franavin/tdse-tf_2026-1erC_3-1/README.md

# FIUBA - Electrónica - Taller de Sistemas Embebidos
## Trabajo Final - 2026-1c - 3-1: Estación Hidropónica

### Bitácora de Entregas
| N° | Detalles | Fecha | Deadline |
| :--: | :--- | :---: | :---: |
| 01 | README.md | 08/05/26 | Semana 08 |
| 02 | Propuesta.md |23/05/26 | Semana 11 |
| 03 | Informe_de_Avance.md |12/06/26 | Semana 14 |
| 04 | Memoria_Video_Código.md |10/07/26 | Semana 17 |
