franavin/tdse-tf_2026-1erC_3-1/Memoria Técnica/Memoria_Video_Código.md

<div align="center">

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

**UNIVERSIDAD DE BUENOS AIRES**  
**Facultad de Ingeniería**  
**TA134 – Sistemas Embebidos**  
Curso 3 – Grupo 1

# Estación Hidropónica

## Autores
Avincetto, Franco Joaquín — Legajo 106747  
Nishihara, Leonardo — Legajo 88627 

**Fecha:** 20/08/2026  
**Cuatrimestre de cursada:** 1er cuatrimestre 2026  

*Trabajo realizado entre julio de 2026 y agosto de 2026*
</div>

---

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

---

## Registro de versiones

*Historial de revisiones del documento.*

La Tabla 0.1 resume el historial de revisiones y entregas de esta memoria.

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

<em>Tabla 0.1 — Registro de versiones del documento.</em><br><br>

---

# Índice General

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

---

# Capítulo 1: Introducción general

## 1.1 Análisis de necesidad y objetivo
El cultivo hidropónico es una técnica en la cual se prescinde por completo de un suelo en el que poner aquello que se quiere cultivar, utilizando en su lugar minerales disueltos en agua para formar el sustrato. Para que este método sea exitoso se requiere de ciertos cuidados estrictos en el entorno en que se desarrolla, tanto por los ciclos de oxigenación y el riego de las raíces como por la temperatura y humedad del ambiente. 

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

<div align="center">
  Rainbird
<br>
<em>Figura 1.2 — Programador Riego Por Goteo Grifo Automatico Rain Bird.</em>
  </div>
<br>

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

## 1.3 Justificación del enfoque técnico

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

Las limitaciones actuales radican, en primer lugar, en la validación de la etapa de potencia y el entorno, ya que para comprobar que la etapa de potencia funcionaría utilizamos la observación a partir de la conmutación de los relés a nivel lógico, y no unas bombas de agua conectadas a 220V con válvulas de agua conectada, esto es lo que quedaría para un estudio posterior. 

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

---

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

## 2.1 Requisitos
| Grupo | ID | Descripción |
| :---- | :---- | :---- |
| **Sensores** | 1.1 | **Nivel de agua (Simulado):** Lectura analógica por ADC (polling/DMA) de un potenciómetro, previo paso por un filtro activo Sallen-Key por hardware. |
| | 1.2 | **Clima (Real):** Lectura de temperatura y humedad ambiente utilizando el sensor digital SHT3x a través del bus I2C. |
| | 1.3 | **Interfaz de entrada local:** Lectura no bloqueante (con rutinas de anti-rebote por software) de botones para la navegación del menú y Dip Switches para alternar los modos del sistema (`NORMAL` / `SET_UP`). |
| **Actuadores** | 2.1 | **Actuadores de simulación (Bombas/Ventilación):** Encendido y apagado de LEDs/Relés gestionados por retardos no bloqueantes basados en el tick del Systick (1ms). |
| | 2.2 | **Alarmas sonoras:** Emisión de alertas mediante un Buzzer (accionado por PWM o GPIO) ante fallas críticas del sistema o confirmaciones de guardado. |
| **Interfaz y Comunicaciones** | 3.1 | **Interfaz Visual Local (Display):** Actualización periódica de un menú interactivo en una pantalla OLED (SPI/I2C) para la visualización y configuración de parámetros sin depender de la red. |
| | 3.2 | **Telemetría remota:** Envío de tramas de estado y alertas por UART utilizando un módulo Bluetooth HM-10 para monitoreo desde una aplicación móvil. |
| **Almacenamiento** | 4.1 | **Gestión de Recetas (EEPROM):** Lectura y escritura de parámetros de configuración (tiempos de riego, umbrales térmicos) en una memoria EEPROM externa vía I2C para garantizar la persistencia ante cortes de energía. |

<p align="center"><em>Tabla 2.1: Requisitos del proyecto</em></p>

---
## **2.2\. Casos de Uso**

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

## 2.3 Descripción de módulos principales

En los siguientes puntos desarrollaremos los modulos principales aplicados al proyecto. 

### 2.3.1 Módulo de control y orquestación de la plaqueta NUCLEO
* Implementado sobre una placa de desarrollo STM32 NUCLEO F103RB.
* Ejecuta un scheduler (Ejecutor Cíclico) basado en arreglos de punteros a funciones, disparando cada 1 ms por el SysTick.
* Centraliza la Máquina de Estados Finita (FSM) gobernando el comportamiento macro de la estación.
<div align="center">
image PF259875 en feature-description-include-personalized-no-cpn-large
<br>
<em>Figura 2.1: Placa NUCLEO-F103RB.</em>
  </div>
<br>

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

### 2.3.3 Módulo de medición ambiental
* Compuesto por el sensor digital AHT20 operando bajo el bus I2C.
* Utiliza un driver propio basado en estados internos que permite enviar el comando de medición y ceder el uso del procesador durante los 80 ms físicos requeridos para el cálculo termodinámico, evitando el uso de funciones bloqueantes.

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

### 2.3.5 Módulo de memoria
* Utiliza la memoria externa EEPROM AT24C32 en el bus I2C compartiendo líneas con el sensor AHT20.
* Minimiza la tasa de desgaste de escritura al funcionar como sistema de solo respaldo: se lee una sola vez durante el inicio del sistema (Init) y se escribe de manera exclusiva cuando los valores han sido explícitamente confirmados por el usuario.

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

### 2.3.6 Módulo de telemetría
* Integrado mediante el modulo bluetooth HM-10.
* Opera de forma totalmente asincrónica a través del periférico USART de la STM32, donde veremos que su impacto en el rendimiento computacional de la placa es nulo en estado de reposo, procesando tramas únicamente mediante interrupciones.

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

---

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

Primero realizamos la estructuración a partir de los componentes que podría llegar a tener el sistema, haciendo un Diagrama en Bloques. Seguido a eso, completamos un primer Diagrama de Secuencia que reflejaba prácticamente lo mismo que el de bloques, y pasamos a definir los eventos y estados que deberían tener en un principio.
En los enlaces siguientes se presentan en detalle las tablas de estados definidas para cada módulo.

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

Una vez logrado eso, completamos un último Diagrama de Secuencia donde en los mensajes contenía la impronta de lo que iba a volcarse en el código.

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

<p align="center"><em>Figura 3.1: Diagrama de bloques</em></p>

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

<p align="center"><em>Figura 3.2: Diagrama de Secuencia</em></p>

## 3.2 Diseño de hardware
El hardware constará de una placa base para los siguientes periféricos:

<div align="center">
Esquematico
<br>
<em>Figura 3.3: Esquemático del sistema.</em>
  </div>
<br>

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

## 3.3 Diseño de firmware
El sistema no utiliza un RTOS, sino una arquitectura bare-metal soportada por un Ejecutor Cíclico (Super-Loop). La interrupción a partir de SysTick levanta un flag cada 1ms exacto, lo que permite que la función principal main() vaya despachando cíclicamente el array de las tareas en task_cfg_list:
1. `task_sensor_update()`
2. `task_system_update()`
3. `task_actuator_update()`
4. `task_display_update()`
5. `bluetooth_update()`

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

  * `ST_SYS_NORMAL_IDLE`: Monitoreo del clima y espera hasta el próximo riego. 

  * `ST_SYS_NORMAL_WATERING`: Riego activo transitorio (bomba encendida).

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

  * `ST_SYS_SET_UP`: Navegación por menú interactivo (ciclo automático detenido).

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

* Teclado y Relé: Transitan por UP/OPEN -> FALLING/CLOSING -> DOWN/CLOSED -> RISING/OPENING.

* Nivel de agua y Temperatura: Transitan desde estado OK hacia CRITICAL/HIGH mediante estados transitorios FALLING/RISING para asegurar la permanencia en el umbral crítico antes de lanzar la alarma.

### 3.3.3 Máquinas de estado de los Actuadores
Controlan periféricos sin usar retardos:

* Buzzer: Alterna entre ON, OFF cíclicamente para alarmas o emite tonos de confirmación.

* LEDs: Estados fijos (Verde, Amarillo, Rojo) o parpadeantes para actualizaciones de pantalla.

* Display: Basado en pantallas (TELEMETRY, MENU, FAULT).

* Buses (BT/EEPROM): Estados que manejan la transmisión y recepción (IDLE, TX_BUSY, RX_READY, ERROR).

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

---

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

Lo primero que probamos en el módulo de actuadores, fueron los módulos de relés y el de leds, esta primer prueba era fundamental, ya que la estación hidropónica no sería nada si no se pudieran mover los relés con los que se mueven la bomba del tanque de agua y el ventilador. Algo a destacar para con el módulo de relés es que no lo alimentamos directamente con la plaqueta NUCLEO sino que optamos por utilizar una fuente externa (5V 400mA), sabiendo que es capaz de entregar hasta 100mA como máxima, y el módulo de relés puede llegar a consumir entre unos 50mA por canal. Por lo tanto, antes de comenzar a hacer algo con el resto de módulos, decidimos medir la corriente que consumían los relés conectado con la fuente externa, y es acá donde pudimos observar que el consumo de cada módulo rondaba entre 54mA y 57mA, lo que nos daba un consumo total entre ambos de unos 108mA hasta 114mA, superando ampliamente la cantidad que nos podía dar la placa NUCLEO.

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

Para el potenciómetro se decidió utilizar uno de valor 1kΩ, ya que estos conversores trabajan cargando un capacitor de retención, donde para que la lectura sea precisa y rápida, la señal externa debe tener una baja impedancia. Por lo tanto, al estar conectado a la fuente de 3.3V de la placa, este nos entregaba un consumo que se aproximaba los 3.3mA que debería tener.

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

<p align="center"><em>Tabla 4.1: Ensayos y Resultados de Hardware.</em></p>

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

</div>

<p align="center"><em>Tabla 4.2: Ensayos y Resultados de Software.</em></p>

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

Por esto, es que decidimos ir probando módulo por módulo, incluyéndolos de a poco y una vez que teníamos el sistema completo funcional, pasamos a la parte de desarrollar el sistema en un PCB del tipo perforado.

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

Comenzamos desarrollando una plaqueta la cual esta iba a contener la mayoría de módulos y sensores del sistema, ya que es dónde íbamos a colocar la placa NUCLEO, que es la que comanda todas las operaciones para que el sistema funcione. En este fuimos integrando poco a poco las conexiones con cables del tipo multipar, asegurando primero, las conexiones de GND, de 5V y 3.3V y luego pasar a las conexiones de los pines de funcionalidad que necesitaba cada módulo en particular. Por otro lado, se decidió utilizar un segundo PCB perforado para no saturar tanto las conexiones dentro del PCB principal, y además, en este segundo PCB podríamos aislar las conexiones al relé, el cual tiene la conexión a la fuente externa, y otros módulos como el de memoria EEPROM, y el módulo AHT20, sensor de temperatura y humedad.

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

**Video de integración en funcionamiento**  

[Link al vídeo de integración del proyecto](https://youtu.be/7Y0e8ubY0-0)

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

## 4.4 Medición y análisis de consumo
Para la medición y análisis de consumo separamos en dos partes, debido a que se hicieron uso de los dos tipos de voltajes que nos podía entregar la placa del sistema, una alimentación de 5V y la otra de 3.3V. Por otro lado, teníamos el consumo de la fuente externa para el módulo de relés que se había medido previamente sin tener el sistema completa, la cuál de igual manera una vez insertada al resto de módulos no varió su consumo, ya que esta fuente simplemente actúa para encender los relés, este módulo por otro lado también tiene una alimentación de 3.3V del sistema que es para la activación lógica de los pines IN1 y IN2 que están en la placa del módulo de relés.  

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

**Consumo de relés durante los distintos modos de operación** 

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

Análisis:
- La potencia se calculó como `P = V * I`, usando `V = 5 V` y corriente pico medida en cada modo.
- El peor caso medido con la alimentación de la placa fue `14.1 mA` a `5 V`, equivalente a `0.070 W`.
- El peor caso medido con la alimentación de la fuente externa fue `112 mA` a `5 V`, equivalente a `0.560 W`.
- El sistema se mantiene por debajo de `1 W`, por lo que puede alimentarse sin inconvenientes con fuentes comerciales 220VAC->5 V de baja potencia.
- La diferencia entre los distintos modos de operación es baja para cualquier tipo de alimentación, lo que hace que sea un sistema consistente en su consumo.

## 4.5 Console and Build Analyzer

En las siguientes figuras se muestran el reporte de uso de memoria del build; se observa un uso bajo de RAM y FLASH (≈16,88% y ≈40,81%), dejando margen para futuras extensiones para el sistema.

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

## 4.6 Medición y análisis de WCET por tarea

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

</div>

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

## 4.7 Cálculo del factor de uso de CPU (U)

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

### 1. Factor de Uso Nominal (Régimen Permanente / LET)

Tomando los tiempos típicos de ejecución ($LET$):

$$\sum C_{nominal} = 190 + 34 + 62 + 13 + 9 = 308\ \mu\text{s}$$

$$U_{nominal} = \frac{308\ \mu\text{s}}{1000\ \mu\text{s}} = 0{,}308 \implies \mathbf{30{,}8\%}$$

> **Interpretación:** En operación normal, el microcontrolador opera holgadamente con un **$69{,}2\%$ de tiempo ocioso (Idle)**.

### 2. Factor de Uso en el Peor Caso Registrado (Pico / WCET)

Tomando la suma de los máximos absolutos ($WCET$):

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

$$U_{peor\_caso} = \frac{1.137.452\ \mu\text{s}}{1000\ \mu\text{s}} = 1137{,}45 \implies \mathbf{1137{,}45\%}$$

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

Apartir de lo calculado se puede realizar el siguiente análisis:

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

## 4.9 Cumplimiento de requisitos
En la siguiente sección demostramos todas las implementaciones que habíamos previsto en un informe anterior, los cuáles en partes generales pudimos concretar todos tal como se describieron o sino con modificaciones mínimas para hacer un sistema más llevadero. 

| Estado | Descripción |
|-----|---|
| 🟢 | Se implementó |
| 🔴 | No se implementó |

#### **Sensores**  

| ID | Descripción | Estado |
| :---- | :---- | :---- |
| 1.1 | **Nivel de agua (Simulado):** Lectura analógica por ADC (polling/DMA) de un potenciómetro de 1k ohm <br> Se logra implementar mediante el uso de las funciones ADC del microcontrolador la lectura de un potenciometro que en nuestro caso imitaría el nivel del agua que contiene la Estación Hidropónica. | 🟢  |
| 1.2 | **Clima (Real):** Lectura de temperatura y humedad ambiente utilizando el sensor digital AHT20 a través del bus I2C. | 🟢 |
| 1.3 | **Interfaz de entrada local:** Lectura no bloqueante (con rutinas de anti-rebote por software) de botones para la navegación del menú y botones para alternar los modos del sistema (`NORMAL` / `SET_UP`). <br> Logramos concretar una interfaz en la cual podemos navegar mediante el uso de 4 botones de una matriz de botones, de esta manera tenemos, un boton para cambiar el modo de setup a configuración, luego dos de navegación que serán también los que incrementen y decrementen los valores, y por último uno de enter/guardado. | 🟢 | 
<p align="center"><em>Tabla 4.7: Tabla de implementaciones: Sensores.</em></p>

#### **Actuadores**  

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

#### **Interfaz y comunicaciones**  

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

#### **Almacenamiento**  

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

# Capítulo 5: Conclusiones

## 5.1 Resultados obtenidos

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

## 5.2 Lecciones aprendidas

* **Impacto severo del código bloqueante:** Se comprobó empíricamente cómo el uso de retardos pasivos (como `HAL_Delay`) o las esperas síncronas en los buses de comunicación (I2C/UART) colapsan un sistema reactivo. Esta vulnerabilidad, detectada en el manejo de la memoria y la transmisión Bluetooth por *polling*, evidenció que en sistemas de tiempo real estricto es mandatorio delegar estos procesos al hardware (Interrupciones o DMA).
* **Aislación y dominios de potencia:** Se comprendió la necesidad estricta de separar las fuentes de alimentación. Se constató que la placa NUCLEO no puede suministrar los picos de corriente necesarios para conmutar las bobinas de los relés (~110 mA) sin requerir una fuente externa dedicada de 5V.
* **Filtrado y acondicionamiento de señales:** Se evidenció la importancia de aplicar máquinas de estado con retardos integrados para el anti-rebote (*debounce*) de botones y el filtrado temporal del ADC, evitando falsos positivos causados por ruido eléctrico o fluctuaciones mecánicas.
* **Armado de la placa:** Es altamente recomendable trabajar con espacio suficiente al soldar. Esto evita el amontonamiento de cables, facilita el acceso con el soldador, previene fallas por acumulación de estaño y hace que cualquier error sea mucho más fácil de detectar y reparar. Priorizar el trabajo cómodo y limpio.

## 5.3 Próximos pasos

* **Transición a hardware físico industrial:** Reemplazar los componentes de simulación (potenciómetro y LEDs) por sensores de nivel de agua de flotador magnético y bombas sumergibles de 220V gestionadas por contactores o relés de estado sólido (SSR).
* **Optimización de comunicaciones:** Migrar las transmisiones UART del módulo Bluetooth y las rutinas I2C de la EEPROM hacia una arquitectura basada netamente en Interrupciones (IT) o Acceso Directo a Memoria (DMA), eliminando así los bloqueos residuales en la tarea del sistema.
* **Expansión del control agronómico:** Integrar circuitos de acondicionamiento para sondas analógicas de pH y conductividad eléctrica (EC), junto con micro-bombas peristálticas para automatizar la dosificación de nutrientes en lazo cerrado.

---

# Capítulo 6: Uso de herramientas de IA

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

- Leonardo:
  - Consulta de GFM (GitHub Flavored Markdown).
  - Le pasamos 2 memorias técnicas de las de ejemplo y le pedimos que extraiga el esqueleto de secciones y subsecciones para poder empezar a completar nuestro documento.
  - Consulta sobre componentes y conexiones.
  - Checkeo de redacción de la memoria técnica.
  - Consuta sobre funciones del LT Spice para dibujar el esqumático.

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

---

# Capítulo 7: Bibliografía y referencias

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

Referencias internas del repositorio:

---

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
