franavin/tdse-tf_2026-1erC_3-1/ENTREGA_FINAL_MEMORIA/listado de cosas hechas con IA.txt

Franco:
1.Consultas sobre la estructuración para el código y las funciones específicas necesarias para concretar el código (ej. archivos de memoria eeprom o bluetooth).
2.Consultas por errores y warnings que aparecieron en el código.
3.Consultas sobre comportamientos no deseados a la hora de tener el sistema ejecutándose, tanto en hardware como firmware.
4.Utilización de aplicación Mermaid para realizar los diagramas de secuencia.

Leonardo:
1.Le pasamos 2 memorias técnicas de referencia y le pedimos que extraiga el esqueleto de secciones y subsecciones para poder empezar a completar nuestro documento.
2.Consulta sobre componentes y conexiones.
3.Checkeo de redacción de la memoria técnica.
4.Consuta sobre funciones del LT Spice para dibujar el esqumático.
5.Consulta de GFM (GitHub Flavored Markdown).
6.Generación de Statecharts.
7.Consulta del código.

Común:
1.apoyo en redacción y ajuste de memoria técnica.
2.apoyo extensivo en programación STM32 (estructura, módulos y ajustes).
