franavin/tdse-tf_2026-1erC_3-1/Memoria Técnica/Comentarios.md

**En la siguiente carpeta se encontraran los archivos necesarios para completar la memoria técnica del proyecto final, donde se incluirán imagenes, código y referencias que se fueron utilizando en el mismo.**
