franavin/tdse-tf_2026-1erC_3-1/Memoria Técnica/IMAGENES/AHT20.png

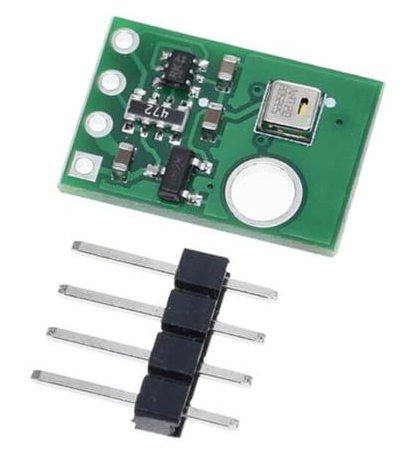
Memoria Técnica/IMAGENES/AHT20.png
