franavin/tdse-tf_2026-1erC_3-1/Memoria Técnica/IMAGENES/Diagrama de Secuencia Final - Estación Hidropónica.png

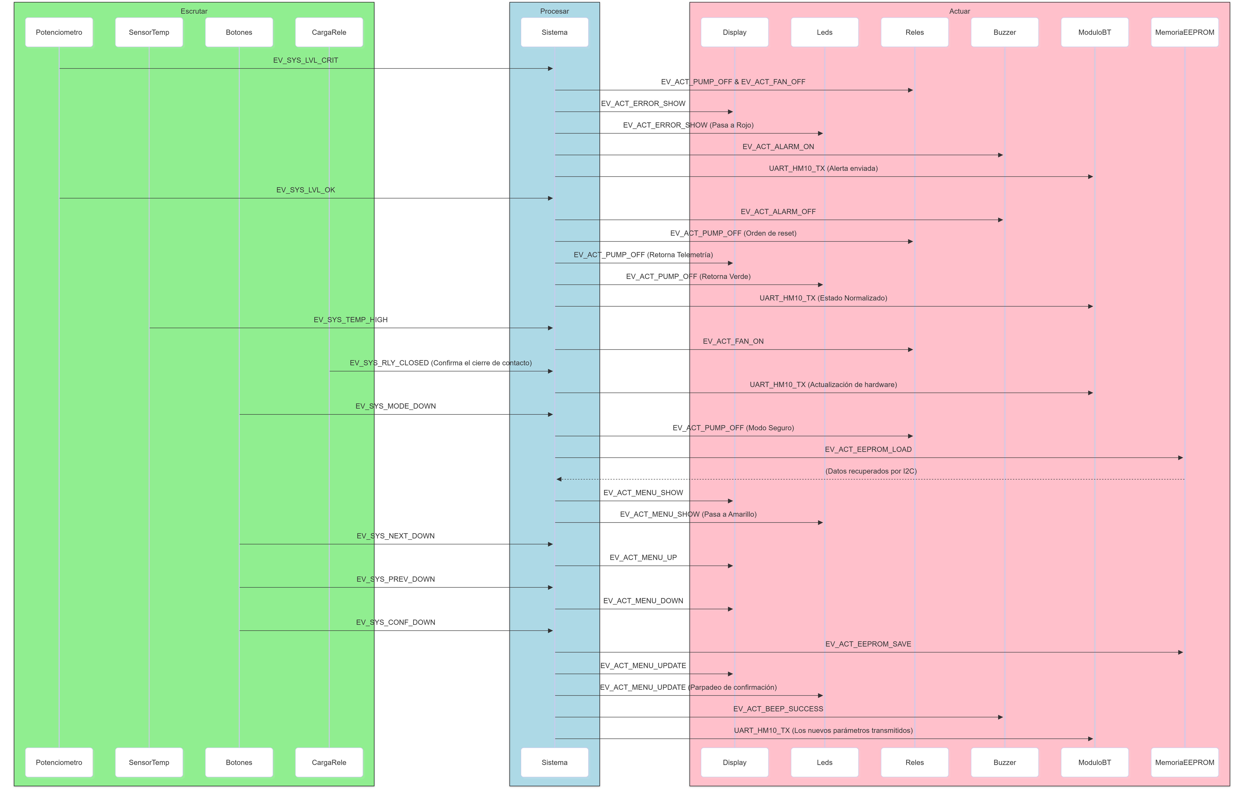
Memoria Técnica/IMAGENES/Diagrama de Secuencia Final - Estación Hidropónica.png
