franavin/tdse-tf_2026-1erC_3-1/Memoria Técnica/IMAGENES/EEPROM.png

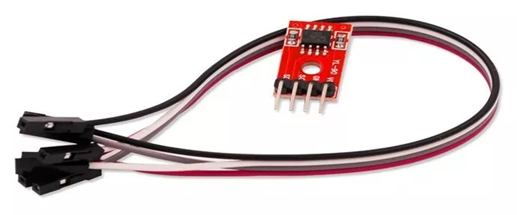
Memoria Técnica/IMAGENES/EEPROM.png
