franavin/tdse-tf_2026-1erC_3-1/Memoria Técnica/IMAGENES/HM-10.png

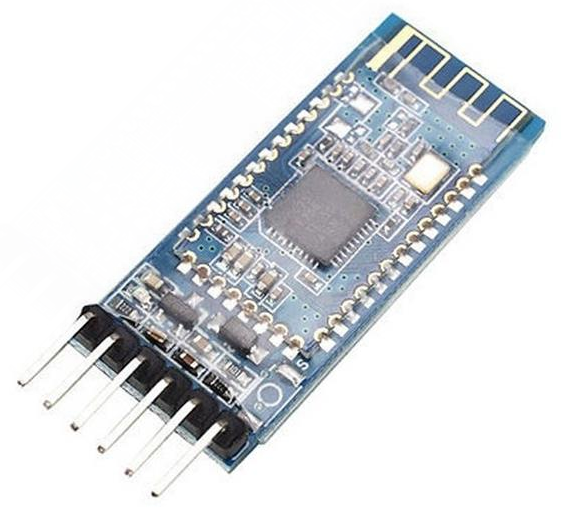
Memoria Técnica/IMAGENES/HM-10.png
