franavin/tdse-tf_2026-1erC_3-1/Memoria Técnica/IMAGENES/image.PF259875.en.feature-description-include-personalized-no-cpn-large.webp

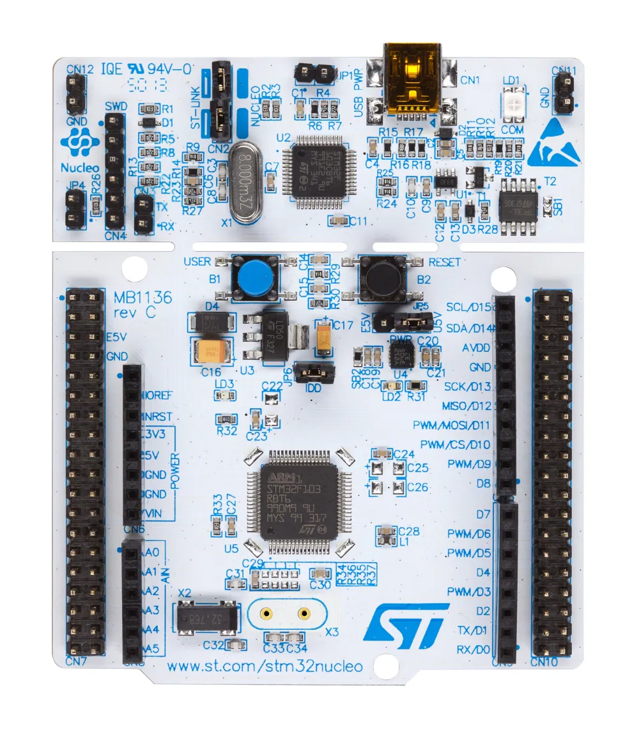
Memoria Técnica/IMAGENES/image.PF259875.en.feature-description-include-personalized-no-cpn-large.webp
