franavin/tdse-tf_2026-1erC_3-1/Memoria Técnica/IMAGENES/LCD.png

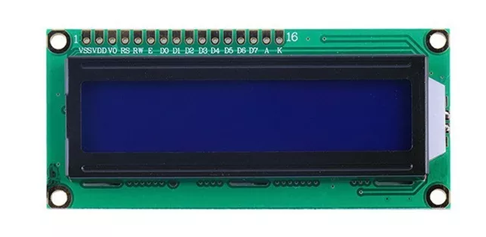
Memoria Técnica/IMAGENES/LCD.png
