franavin/tdse-tf_2026-1erC_3-1/Memoria Técnica/IMAGENES/releINT.png

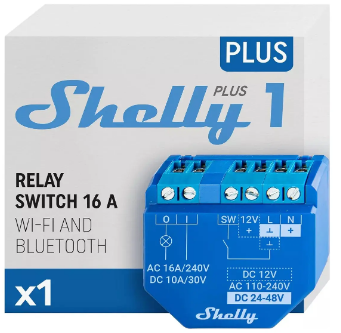
Memoria Técnica/IMAGENES/releINT.png
