franavin/tdse-tf_2026-1erC_3-1/Memoria Técnica/IMAGENES/STCACT_DISP_TELE.png

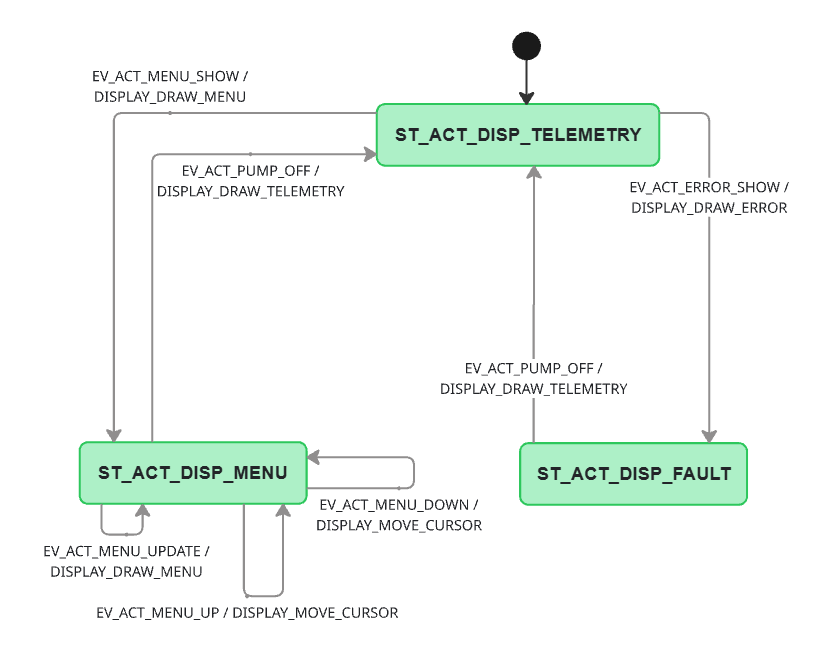
Memoria Técnica/IMAGENES/STCACT_DISP_TELE.png
