franavin/tdse-tf_2026-1erC_3-1/Memoria Técnica/IMAGENES/STCACT_LED.png

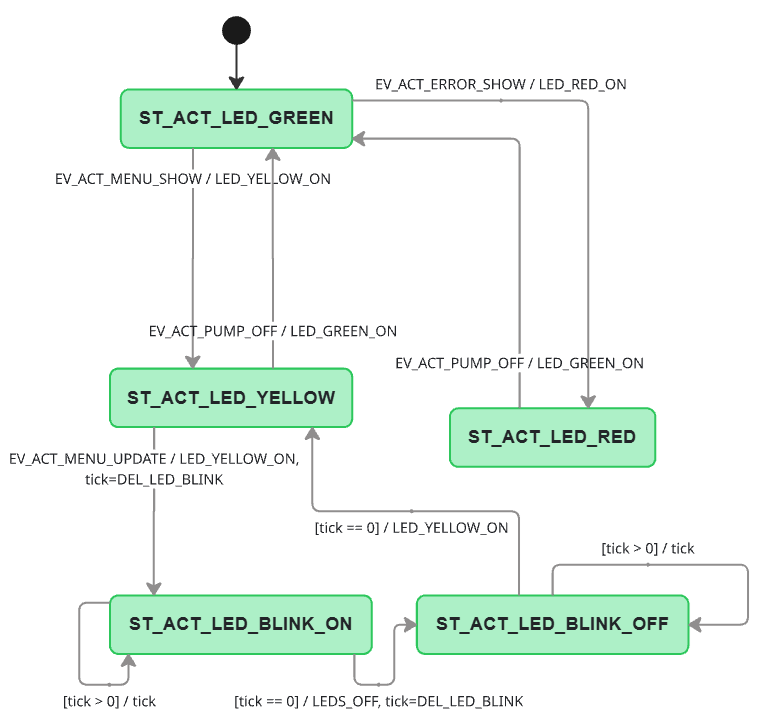
Memoria Técnica/IMAGENES/STCACT_LED.png
