franavin/tdse-tf_2026-1erC_3-1/Memoria Técnica/IMAGENES/STCSensor_BTN.png

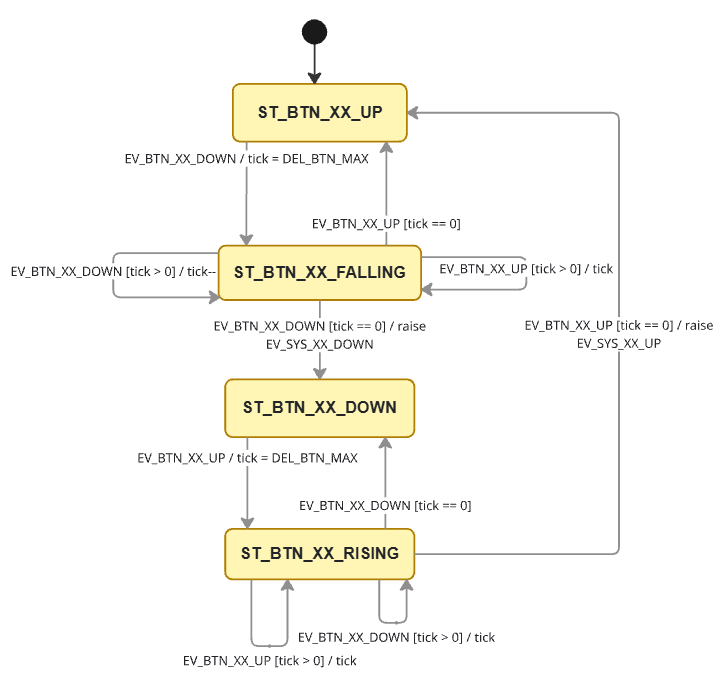
Memoria Técnica/IMAGENES/STCSensor_BTN.png
