franavin/tdse-tf_2026-1erC_3-1/ENTREGA_FINAL_MEMORIA/CODIGO_tdse_tf_estacion-hidroponica_V3.0/Core/Inc/main.h

#define B1_Pin GPIO_PIN_13
#define B1_GPIO_Port GPIOC
#define B1_EXTI_IRQn EXTI15_10_IRQn
#define MODE_Pin GPIO_PIN_0
#define MODE_GPIO_Port GPIOC
#define CONF_Pin GPIO_PIN_1
#define CONF_GPIO_Port GPIOC
#define NEXT_Pin GPIO_PIN_2
#define NEXT_GPIO_Port GPIOC
#define PREV_Pin GPIO_PIN_3
#define PREV_GPIO_Port GPIOC
#define USART_TX_Pin GPIO_PIN_2
#define USART_TX_GPIO_Port GPIOA
#define USART_RX_Pin GPIO_PIN_3
#define USART_RX_GPIO_Port GPIOA
#define LD2_Pin GPIO_PIN_5
#define LD2_GPIO_Port GPIOA
#define RLY_BOMBA_Pin GPIO_PIN_6
#define RLY_BOMBA_GPIO_Port GPIOA
#define RLY_VENT_Pin GPIO_PIN_7
#define RLY_VENT_GPIO_Port GPIOA
#define FBK_BOMBA_Pin GPIO_PIN_0
#define FBK_BOMBA_GPIO_Port GPIOB
#define FBK_VENT_Pin GPIO_PIN_1
#define FBK_VENT_GPIO_Port GPIOB
#define BZZR_Pin GPIO_PIN_2
#define BZZR_GPIO_Port GPIOB
#define D6_Pin GPIO_PIN_10
#define D6_GPIO_Port GPIOB
#define D9_Pin GPIO_PIN_7
#define D9_GPIO_Port GPIOC
#define D7_Pin GPIO_PIN_8
#define D7_GPIO_Port GPIOA
#define D8_Pin GPIO_PIN_9
#define D8_GPIO_Port GPIOA
#define TMS_Pin GPIO_PIN_13
#define TMS_GPIO_Port GPIOA
#define TCK_Pin GPIO_PIN_14
#define TCK_GPIO_Port GPIOA
#define LED_VERDE_Pin GPIO_PIN_10
#define LED_VERDE_GPIO_Port GPIOC
#define LED_AMARILLO_Pin GPIO_PIN_11
#define LED_AMARILLO_GPIO_Port GPIOC
#define LED_ROJO_Pin GPIO_PIN_12
#define LED_ROJO_GPIO_Port GPIOC
#define SWO_Pin GPIO_PIN_3
#define SWO_GPIO_Port GPIOB
#define D5_Pin GPIO_PIN_4
#define D5_GPIO_Port GPIOB
#define D4_Pin GPIO_PIN_5
#define D4_GPIO_Port GPIOB
