franavin/tdse-tf_2026-1erC_3-1/ENTREGA_FINAL_MEMORIA/CODIGO_tdse_tf_estacion-hidroponica_V3.0/app/inc/task_sensor_attribute.h

#ifndef TASK_SENSOR_ATTRIBUTE_H_
#define TASK_SENSOR_ATTRIBUTE_H_

/********************** CPP guard ********************************************/
#ifdef __cplusplus
extern "C" {
#endif

/********************** inclusions *******************************************/
#include "main.h"
#include "task_system_attribute.h"
/********************** macros ***********************************************/

/********************** typedef **********************************************/
/* Events to excite Task Sensor */
typedef enum task_sensor_ev {
						EV_RAW_UP,
						EV_RAW_DOWN
					} task_sensor_ev_t;

/* States of Task Sensor */
typedef enum task_sensor_st {
					 ST_SNSR_UP,
					 ST_SNSR_FALLING,
					 ST_SNSR_DOWN,
					 ST_SNSR_RISING
	 	 	 	 	 } task_sensor_st_t;

/* Identifier of Task Sensor */
typedef enum task_sensor_id {
					 ID_BTN_MODE,
					 ID_BTN_CONF,
					 ID_BTN_NEXT,
					 ID_BTN_PREV,
					 ID_RLY_FB_PUMP, // Lazo cerrado de la bomba
					 ID_RLY_FB_FAN, // Lazo cerrado del ventilador
					 ID_SENS_LVL     // ADC: Sensor de nivel de agua
				 	 } task_sensor_id_t;


typedef struct
{
	task_sensor_id_t	identifier;
	GPIO_TypeDef *		gpio_port;
	uint16_t			pin;
	GPIO_PinState		pressed;
	uint32_t			tick_max;
	task_system_ev_t	signal_up;
	task_system_ev_t	signal_down;
} task_sensor_cfg_t;

typedef struct
{
	uint32_t			tick;
	task_sensor_st_t	state;
	task_sensor_ev_t	event;
} task_sensor_dta_t;

/********************** external data declaration ****************************/
extern task_sensor_dta_t task_sensor_dta_list[];

/********************** external functions declaration ***********************/

/********************** End of CPP guard *************************************/
#ifdef __cplusplus
}
#endif

#endif /* TASK_SENSOR_ATTRIBUTE_H_ */

/********************** end of file ******************************************/
