franavin/tdse-tf_2026-1erC_3-1/ENTREGA_FINAL_MEMORIA/CODIGO_tdse_tf_estacion-hidroponica_V3.0/app/inc/task_actuator_interface.h

#ifndef TASK_ACTUATOR_INTERFACE_H_
#define TASK_ACTUATOR_INTERFACE_H_

/********************** CPP guard ********************************************/
#ifdef __cplusplus
extern "C" {
#endif

/********************** inclusions *******************************************/
#include "task_actuator_attribute.h"
/********************** macros ***********************************************/

/********************** typedef **********************************************/

/********************** external data declaration ****************************/

/********************** external functions declaration ***********************/
extern void put_event_task_actuator(task_actuator_ev_t event, task_actuator_id_t identifier);

/********************** End of CPP guard *************************************/
#ifdef __cplusplus
}
#endif

#endif /* TASK_ACTUATOR_INTERFACE_H_ */

/********************** end of file ******************************************/
