franavin/tdse-tf_2026-1erC_3-1/ENTREGA_FINAL_MEMORIA/CODIGO_tdse_tf_estacion-hidroponica_V3.0/app/src/task_actuator_interface.c

/********************** inclusions *******************************************/
/* Project includes */
#include "main.h"

/* Demo includes */
#include "logger.h"
#include "dwt.h"

/* Application & Tasks includes */
#include "board.h"
#include "app.h"
#include "task_actuator_interface.h"
#include "task_actuator_attribute.h"

/********************** macros and definitions *******************************/

/********************** internal data declaration ****************************/

/********************** internal functions declaration ***********************/

/********************** internal data definition *****************************/

/********************** external data declaration ****************************/

/********************** external functions definition ************************/
void put_event_task_actuator(task_actuator_ev_t event, task_actuator_id_t identifier)
{
	task_actuator_dta_t *p_task_actuator_dta;

	p_task_actuator_dta = &task_actuator_dta_list[identifier];

	p_task_actuator_dta->event = event;
	p_task_actuator_dta->flag = true;
}

/********************** end of file ******************************************/
