franavin/tdse-tf_2026-1erC_3-1/ENTREGA_FINAL_MEMORIA/CODIGO_tdse_tf_estacion-hidroponica_V3.0/app/inc/app_it.h

#ifndef APP_IT_H_
#define APP_IT_H_

/********************** CPP guard ********************************************/
#ifdef __cplusplus
extern "C" {
#endif

/********************** inclusions *******************************************/

/********************** macros ***********************************************/

/********************** typedef **********************************************/

/********************** external data declaration ****************************/
extern volatile uint32_t g_app_tick_cnt;

/********************** external functions declaration ***********************/
extern void app_it_init(void);

/********************** End of CPP guard *************************************/
#ifdef __cplusplus
}
#endif

#endif /* APP_H_ */

/********************** end of file ******************************************/
