franavin/tdse-tf_2026-1erC_3-1/ENTREGA_FINAL_MEMORIA/CODIGO_tdse_tf_estacion-hidroponica_V3.0/app/inc/app.h

#ifndef APP_H_
#define APP_H_

/********************** CPP guard ********************************************/
#ifdef __cplusplus
extern "C" {
#endif

/********************** inclusions *******************************************/

/********************** macros ***********************************************/
#define TEST_0 (0)
#define TEST_1 (1)
#define TEST_2 (2)

#define TEST_X (TEST_0)

/********************** typedef **********************************************/

/********************** external data declaration ****************************/
extern uint32_t g_app_cnt;
extern uint32_t g_app_runtime_us;

extern volatile uint32_t g_app_tick_cnt;

/********************** external functions declaration ***********************/
extern void app_init(void);
extern void app_update(void);

/********************** End of CPP guard *************************************/
#ifdef __cplusplus
}
#endif

#endif /* APP_INC_APP_H_ */

/********************** end of file ******************************************/
