franavin/tdse-tf_2026-1erC_3-1/ENTREGA_FINAL_MEMORIA/CODIGO_tdse_tf_estacion-hidroponica_V3.0/app/inc/systick.h

#ifndef SYSTIC_H_
#define SYSTIC_H_

/********************** CPP guard ********************************************/
#ifdef __cplusplus
extern "C" {
#endif

/********************** inclusions *******************************************/

/********************** macros ***********************************************/

/********************** typedef **********************************************/

/********************** external data declaration ****************************/

/********************** external functions declaration ***********************/
void systick_delay_us(uint32_t delay_us);

/********************** End of CPP guard *************************************/
#ifdef __cplusplus
}
#endif

#endif /* SYSTIC_H_ */

/********************** end of file ******************************************/
