franavin/tdse-tf_2026-1erC_3-1/(commit log)

2026-05-22 Borrador sobre la Propuesta.md
    Creamos este archivo borrador, para que luego, podamos subir el archivo Propuesta.md cuando agreguemos al profesor Musso como Reviewer y así pueda observar el pull request en desarollo sobre el archivo. Pero antes que nada, vamos dejando por asentado la idea que tuvimos para desarrollar en este proyecto final.
2026-06-12 Update and rename borrador-Avance.md to Informe-de-Avance.md
2026-06-12 Creamos nuevamente Informe_de_Avance.md
    Creamos nuevamente el archivo de Avance para que se pueda revisar el archivo completo.
2026-07-09 Proyecto estación hidropónica V1.0
    Subimos la carpeta que contiene el código necesario para la realización del proyecto final, definimos como esta la versión 1.0, ya que lo iremos modficando de acuerdo a los problemas que se presenten.
    [tdse_tf_estacion-hidroponica.cfg]
2026-07-10 Rename Memoria Técnica/Diagrama de Secuencia Final - Estación Hidropónica.png to Memoria Técnica/IMAGENES/Diagrama de Secuencia Final - Estación Hidropónica.png
2026-07-10 Muevo carpeta de codigos a MEMORIA TECNICA
    [tdse_tf_estacion-hidroponica.cfg]
2026-07-10 Renombro la carpeta de codigos
    [tdse_tf_estacion-hidroponica.cfg]
2026-08-06 movi archivos de la carpeta TP FINAL a de memoria tecnica
    [tdse_tf_estacion-hidroponica.cfg]
2026-08-10 Nueva versión del código
    Subimos nueva versión del código que corrige varios errores respecto al anterior.
    [tdse_tf_estacion-hidroponica.cfg]
2026-08-12 Create listado de cosas hechas con IA.txt
2026-08-13 Nueva versión del código
    Subimos nueva versión del código, con correcciones de errores y nuevas optimizaciones para el control de las aplicaciones del proyecto.
    [tdse_tf_estacion-hidroponica.cfg]
2026-08-15 Update listado de cosas hechas con IA.txt
2026-08-15 Imagenes de las pruebas y el pcb completo
2026-08-16 Imagenes sobre la consola y el build analizer
2026-08-20 Actualizar conclusiones y lecciones aprendidas en Memoria
    Se documentaron los resultados obtenidos, lecciones aprendidas y próximos pasos en el desarrollo de una estación hidropónica automatizada. Se enfatizó la importancia de la arquitectura de software y el manejo de recursos en sistemas de tiempo real.
2026-08-20 Add soldering space recommendation
    Added recommendation for sufficient space while soldering to avoid issues.
2026-08-20 Enhance soldering guidelines for better workspace management
    Added a note on prioritizing comfort and cleanliness during soldering to the assembly section.
2026-08-20 Actualiza la gestión de retroiluminación del LCD
    Se reemplazó la gestión de atenuación del display LCD por un potenciómetro para regulación manual de la intensidad lumínica.
2026-08-20 Entrega memoria_video_codigo
    [tdse_tf_estacion-hidroponica.cfg]
2026-08-21 Memory deleted
    [tdse_tf_estacion-hidroponica.cfg]
2026-08-21 Revise figures and descriptions in Memoria_Video_Código.md
    Updated figures and descriptions for system states, sensors, and actuators. Enhanced clarity on operational modes and timing analysis.
2026-08-24 Update reference to technical documents in markdown
    Replaced 'memorias técnicas de las de ejemplo' with 'memorias técnicas de referencia' for clarity.
